ToTo279/BETH/Modelle/Gehaeuese/Stuetze3D.stl

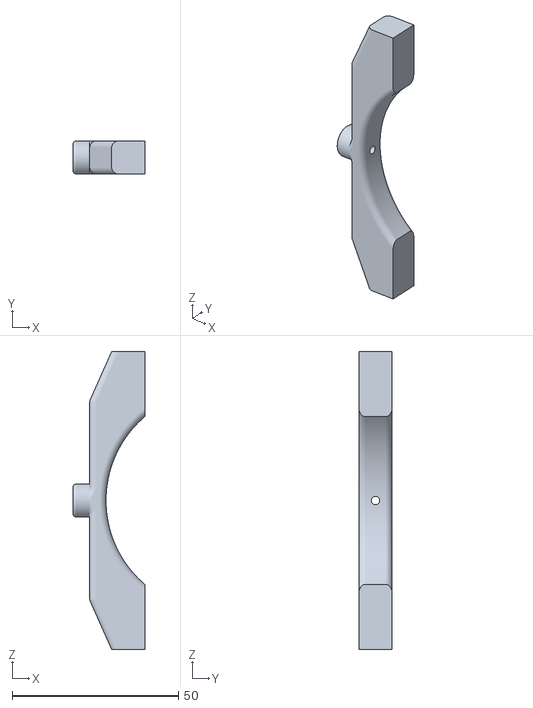
[picture p2: CAD file, 2024-02-24]
Modelle/Gehaeuese/Stuetze3D.stl
21.6 x 10.0 x 89.6
