ToTo279/BETH/Modelle/Gehaeuese/LED3D.stl

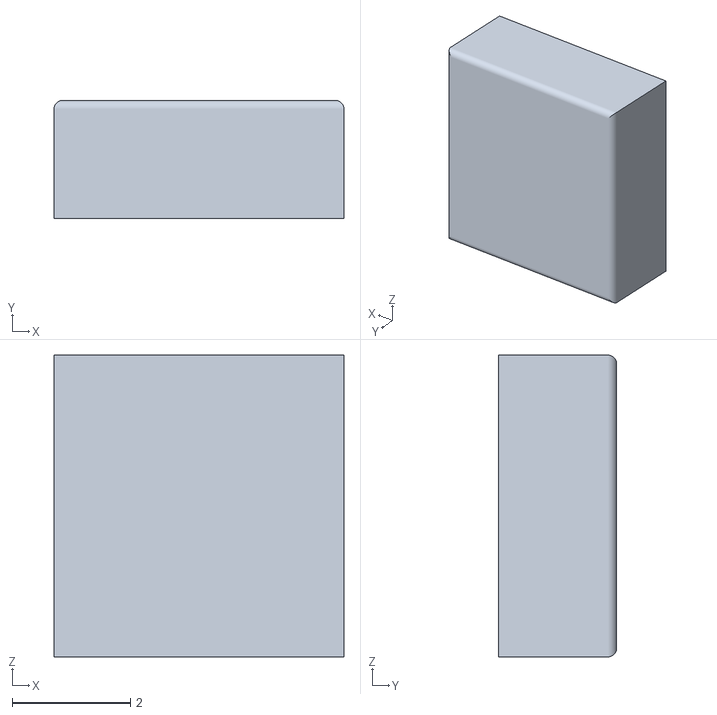
[picture p3: CAD file, 2024-02-24]
Modelle/Gehaeuese/LED3D.stl
4.90 x 2.00 x 5.10
