ToTo279/BETH/(list of files, cad)

Other CAD files:
Modelle/Gehaeuese/LED.ipt
Modelle/Gehaeuese/Oberteil.ipt
Modelle/Gehaeuese/Stuetze.ipt
Modelle/Gehaeuese/Unterteil.ipt
Modelle/MainPCB.ipt
