ToTo279/BETH/Installationsanleitung.md

# Installationsanleitung

## Plattform IO installieren
1. Installiere [Platform IO](https://platformio.org/) auf deinem Entwicklungssystem.

## Raspberry Pi konfigurieren
1. Kopiere den Ordner `Code/raspberryPi` in das Verzeichnis deines Raspberry Pi.
2. Öffne den Ordner `Code/BETH` und verwende PlatformIO, um den Code hochzuladen.

## Raspberry Pi Konfigurationen:
- Starte einen Hotspot mit dem Namen "basepi" und dem Passwort "rasbase331".
