ToTo279/BETH/Modelle/LEDPlatine/LeiterplatteLED.brd

## EAGLE design Modelle/LEDPlatine/LeiterplatteLED.brd (2024-02-24)

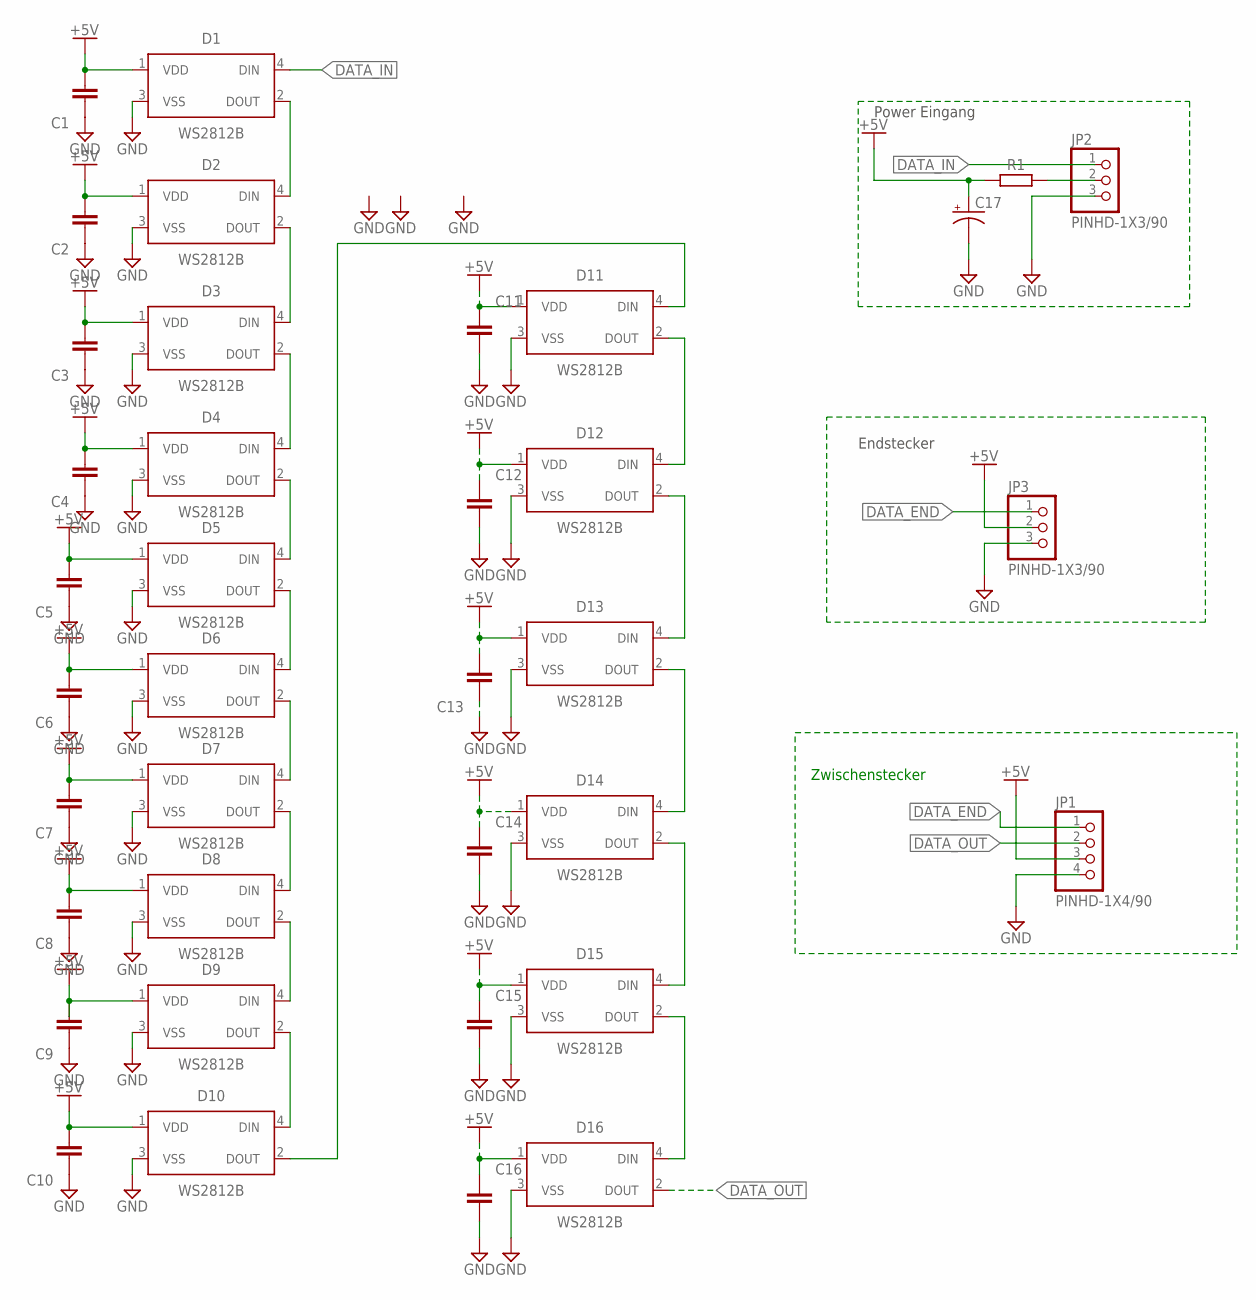
[picture p4: schematic StromlaufplanLED.sch]

Parts:
C1, C2, C3, C4, C5, C6, C7, C8, C9, C10, C11, C12, C13, C14, C15, C16: C_CHIP-1206(3216-METRIC); CAPC3216X135
C17: C-POL-US_TANTALUM-1206(3216-METRIC); CAPMP3216X180N
D1, D2, D3, D4, D5, D6, D7, D8, D9, D10, D11, D12, D13, D14, D15, D16: WS2812B
JP1: PINHD-1X4/90; 1X04/90
JP2, JP3: PINHD-1X3/90; 1X03/90
R1: R_CHIP-1206(3216-METRIC); RESC3216X70

Connections:
+5V: C1.2, C2.2, C3.2, C4.2, C5.2, C6.2, C7.2, C8.2, C9.2, C10.2, C11.1, C12.1, C13.2, C14.1, C15.1, C16.1, C17.1 (+), D1.1 (VDD), D2.1 (VDD), D3.1 (VDD), D4.1 (VDD), D5.1 (VDD), D6.1 (VDD), D7.1 (VDD), D8.1 (VDD), D9.1 (VDD), D10.1 (VDD), D11.1 (VDD), D12.1 (VDD), D13.1 (VDD), D14.1 (VDD), D15.1 (VDD), D16.1 (VDD), JP1.3, JP3.2, R1.1
DATA_END: JP1.1, JP3.1
DATA_IN: D1.4 (DIN), JP2.1
DATA_OUT: D16.2 (DOUT), JP1.2
GND: C1.1, C2.1, C3.1, C4.1, C5.1, C6.1, C7.1, C8.1, C9.1, C10.1, C11.2, C12.2, C13.1, C14.2, C15.2, C16.2, C17.2 (-), D1.3 (VSS), D2.3 (VSS), D3.3 (VSS), D4.3 (VSS), D5.3 (VSS), D6.3 (VSS), D7.3 (VSS), D8.3 (VSS), D9.3 (VSS), D10.3 (VSS), D11.3 (VSS), D12.3 (VSS), D13.3 (VSS), D14.3 (VSS), D15.3 (VSS), D16.3 (VSS), JP1.4, JP2.3, JP3.3
unnamed: D14.2 (DOUT), D15.4 (DIN)
unnamed: D15.2 (DOUT), D16.4 (DIN)
unnamed: JP2.2, R1.2
unnamed: D2.2 (DOUT), D3.4 (DIN)
unnamed: D3.2 (DOUT), D4.4 (DIN)
unnamed: D4.2 (DOUT), D5.4 (DIN)
unnamed: D5.2 (DOUT), D6.4 (DIN)
unnamed: D6.2 (DOUT), D7.4 (DIN)
unnamed: D7.2 (DOUT), D8.4 (DIN)
unnamed: D8.2 (DOUT), D9.4 (DIN)
unnamed: D9.2 (DOUT), D10.4 (DIN)
unnamed: D10.2 (DOUT), D11.4 (DIN)
unnamed: D11.2 (DOUT), D12.4 (DIN)
unnamed: D12.2 (DOUT), D13.4 (DIN)
unnamed: D13.2 (DOUT), D14.4 (DIN)
unnamed: D1.2 (DOUT), D2.4 (DIN)

Notes on the sheet:
Power Eingang
Zwischenstecker
Endstecker

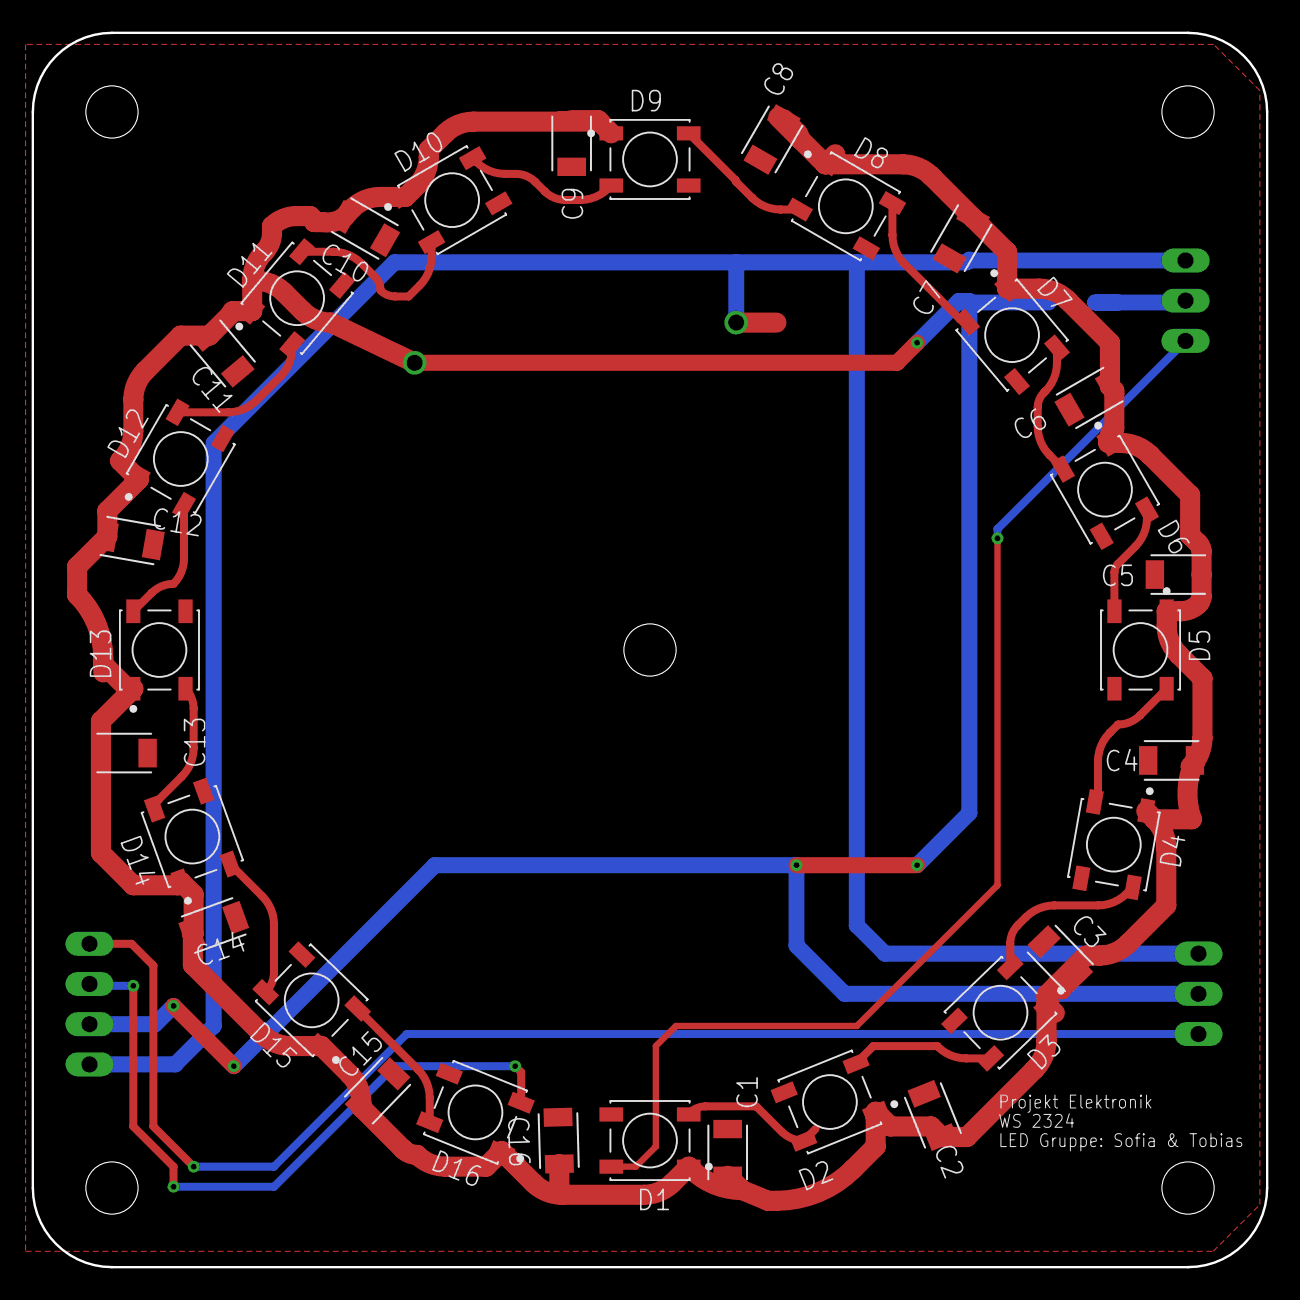
[picture p5: board LeiterplatteLED.brd from above]

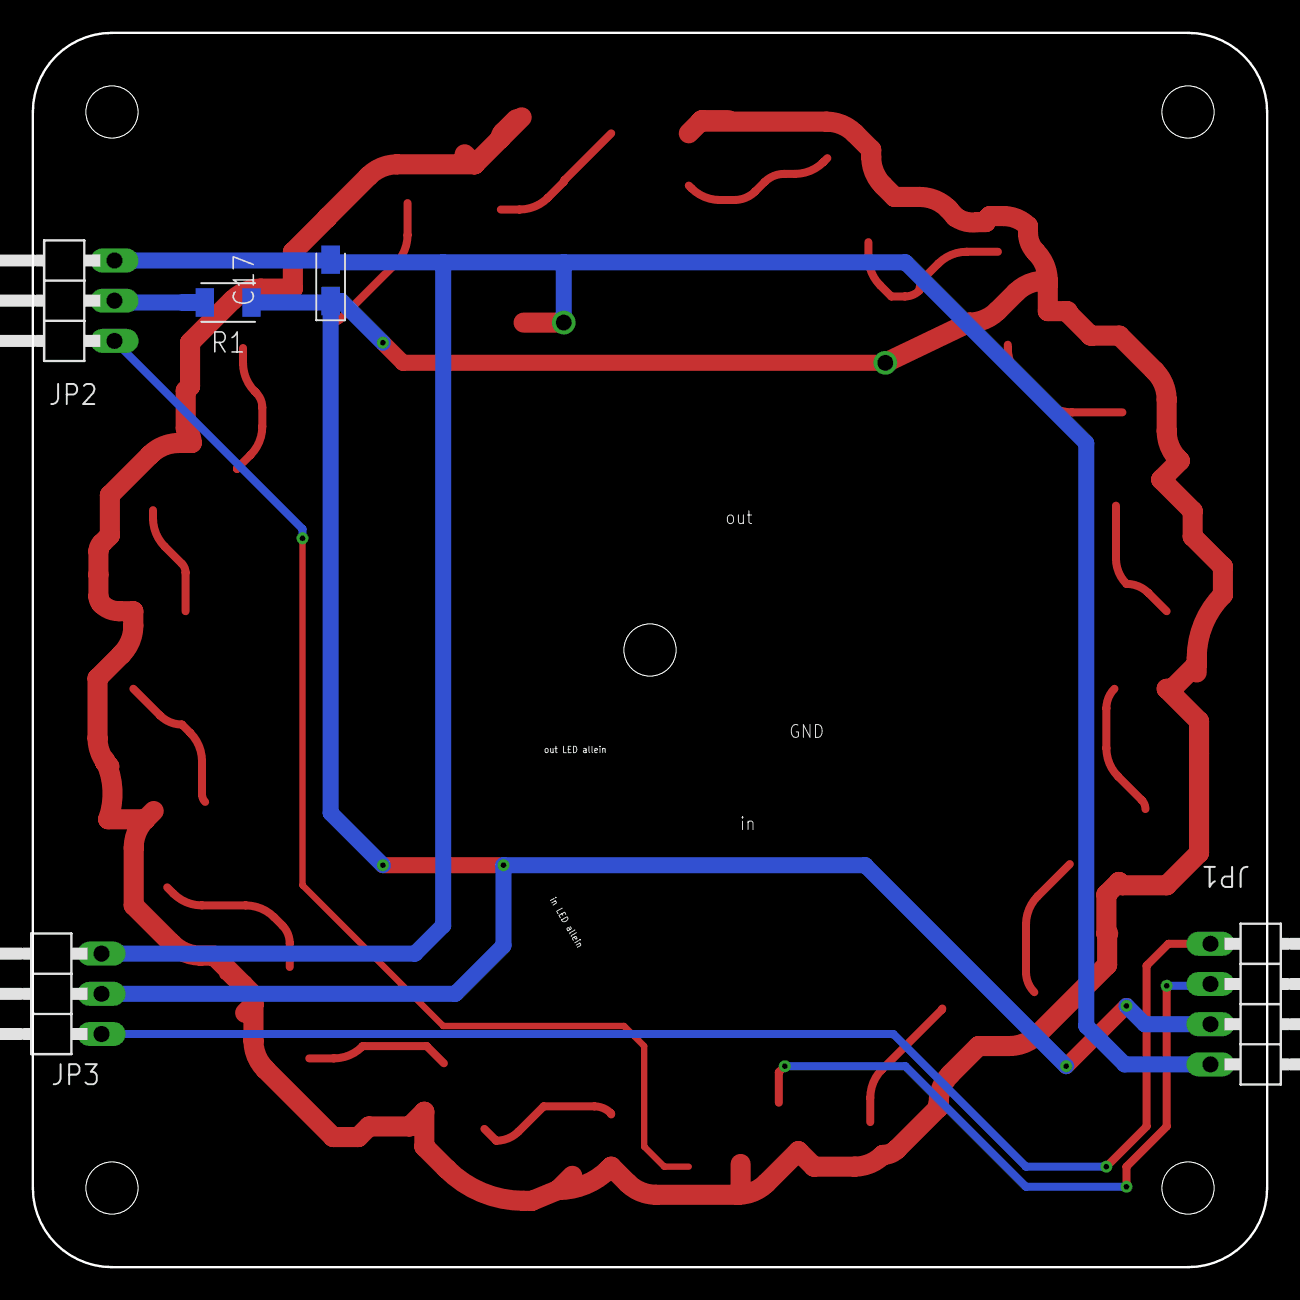
[picture p6: board LeiterplatteLED.brd from below]

Board: 2 copper layers, 78.0 x 78.0 mm, 37 parts (5 on the bottom side), 21 nets.
