ToTo279/BETH/Modelle/EnergieversorgungsPlatine/LeiterplatteEnergieversorgung.brd

## EAGLE design Modelle/EnergieversorgungsPlatine/LeiterplatteEnergieversorgung.brd (2024-02-24)

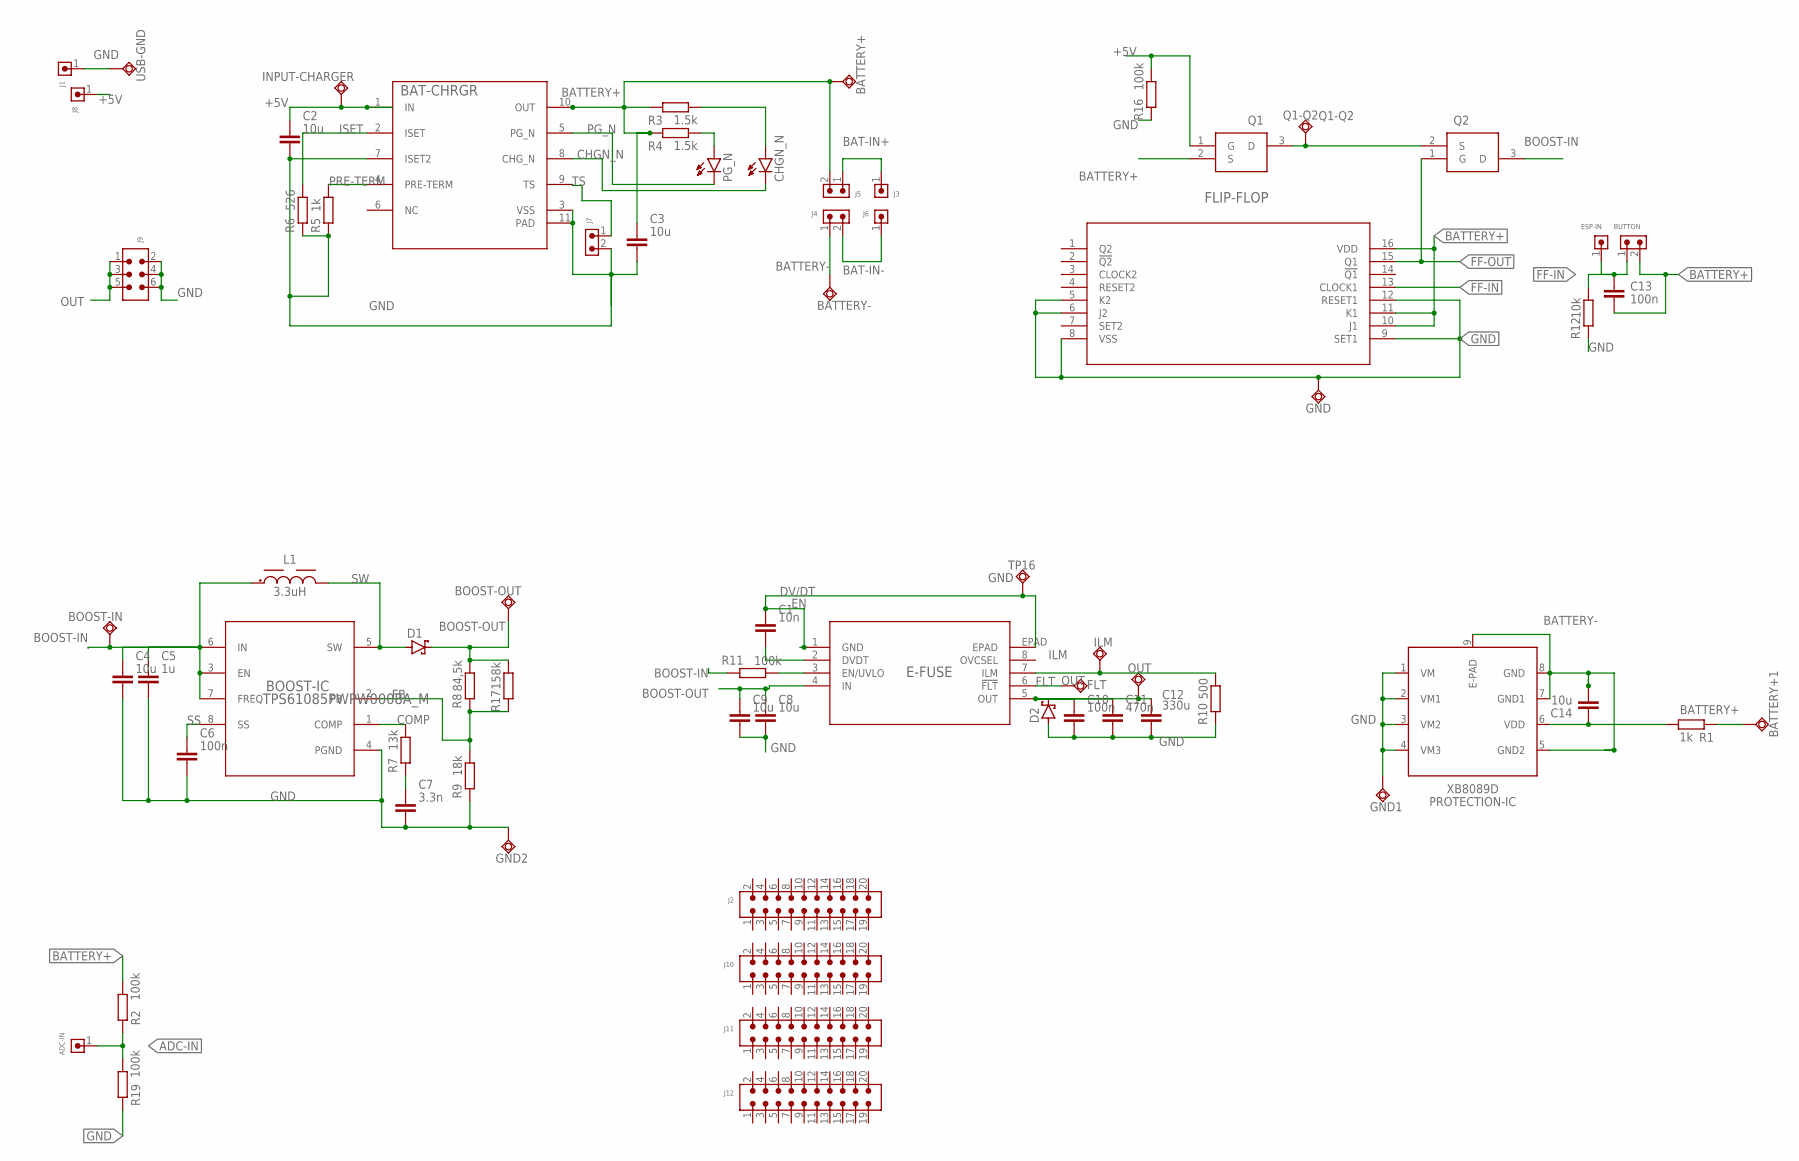
[picture p7: schematic StromlaufplanEnergieversorgung.sch]

Parts:
ADC-IN: 6130XX11121_61300111121; 61300111121
BAT-CHRGR: BQ24092DGQRDGQ0010D_NV_L; DGQ0010D_NV_L
BATTERY+, BATTERY+1: TPSQPAD1-13; P1-13
BATTERY-: TPSQPAD1-13; P1-13
BOOST-IC: TPS61085PWPW0008A_M; PW0008A_M
BOOST-IN: TPSQPAD1-13; P1-13
BOOST-OUT: TPSQPAD1-13; P1-13
BUTTON: 6130XX11121_61300211121; 61300211121
C1: 10n; CAPC3216X135
C2, C3, C4, C8, C9, C14: 10u; CAPC3216X135
C5: 1u; CAPC3216X135
C6, C10, C13: 100n; CAPC3216X135
C7: 3.3n; CAPC3216X135
C11: 470n; CAPC3216X135
C12: 330u; CAPRD550W60D1025H1250B
CHGN_N: LEDCHIPLED_1206; CHIPLED_1206
D1, D2: SCHOTTKY-DIODESMD; SMB
E-FUSE: TPS259620DDARSOIC_20DDAR_TEX-M; SOIC_20DDAR_TEX-M
ESP-IN: 6130XX11121_61300111121; 61300111121
FLIP-FLOP: CD4027BNSRNS16; NS16
FLT: TPSQPAD1-13; P1-13
GND, GND1, GND2: TPSQPAD1-13; P1-13
ILM: TPSQPAD1-13; P1-13
INPUT-CHARGER: TPSQPAD1-13; P1-13
J1, J3, J6, J8: 6130XX11121_61300111121; 61300111121
J2, J10, J11, J12: 6130XX21121_61302021121; 61302021121
J4, J5, J7: 6130XX11121_61300211121; 61300211121
J9: 6130XX21121_61300621121; 61300621121
L1: 3.3uH; WE-PD_7345
OUT: TPSQPAD1-13; P1-13
PG_N: LEDCHIPLED_1206; CHIPLED_1206
PROTECTION-IC: XB8089D
Q1, Q2: DMP3098L-7; SOT96P240X110-3N
Q1-Q2: TPSQPAD1-13; P1-13
R1, R5: 1k; RESC3216X70
R2, R11, R16, R19: 100k; RESC3216X70
R3, R4: 1.5k; RESC3216X70
R6: 526; RESC3216X70
R7: 13k; RESC3216X70
R8: 84,5k; RESC3216X70
R9: 18k; RESC3216X70
R10: 500; RESC3216X70
R12: 10k; RESC3216X70
R17: 158k; RESC3216X70
TP16: TPSQPAD1-13; P1-13
USB-GND: TPSQPAD1-13; P1-13

Connections:
+5V: BAT-CHRGR.1 (IN), C2.1, INPUT-CHARGER.TP, J8.1, Q1.1 (G), R16.2
ADC-IN: ADC-IN.1, R2.2, R19.1
BAT-IN+: J3.1, J5.1
BAT-IN-: J4.2, J6.1
BATTERY+: BAT-CHRGR.10 (OUT), BATTERY+.TP, BATTERY+1.TP, BUTTON.2, C3.1, C13.2, FLIP-FLOP.10 (J1), FLIP-FLOP.11 (K1), FLIP-FLOP.16 (VDD), J5.2, Q1.2 (S), R1.1, R2.1, R3.2, R4.2
BATTERY-: BATTERY-.TP, C14.2, J4.1, PROTECTION-IC.5 (GND2), PROTECTION-IC.7 (GND1), PROTECTION-IC.8 (GND), PROTECTION-IC.9 (E-PAD)
BOOST-IN: BOOST-IC.3 (EN), BOOST-IC.6 (IN), BOOST-IC.7 (FREQ), BOOST-IN.TP, C4.1, C5.1, L1.1, Q2.3 (D), R11.1
BOOST-OUT: BOOST-OUT.TP, C8.1, C9.1, D1.C, E-FUSE.4 (IN), R8.2, R17.2
CHGN_N: BAT-CHRGR.8 (CHG_N), CHGN_N.C
COMP: BOOST-IC.1 (COMP), R7.2
DV/DT: C1.2, E-FUSE.2 (DVDT)
EN: E-FUSE.3 (EN/UVLO), R11.2
FB: BOOST-IC.2 (FB), R8.1, R9.2, R17.1
FF-IN: BUTTON.1, C13.1, ESP-IN.1, FLIP-FLOP.13 (CLOCK1), R12.2
FF-OUT: FLIP-FLOP.15 (Q1), Q2.1 (G)
FLT: E-FUSE.6 (!FLT), FLT.TP
GND: BAT-CHRGR.3 (VSS), BAT-CHRGR.7 (ISET2), BAT-CHRGR.11 (PAD), BOOST-IC.4 (PGND), C1.1, C2.2, C3.2, C4.2, C5.2, C6.2, C7.2, C8.2, C9.2, C10.2, C11.2, C12.2, D2.A, E-FUSE.1 (GND), E-FUSE.EPAD, FLIP-FLOP.5 (K2), FLIP-FLOP.6 (J2), FLIP-FLOP.8 (VSS), FLIP-FLOP.9 (SET1), FLIP-FLOP.12 (RESET1), GND.TP, GND1.TP, GND2.TP, J1.1, J7.2, J9.2, J9.4, J9.6, PROTECTION-IC.1 (VM), PROTECTION-IC.2 (VM1), PROTECTION-IC.3 (VM2), PROTECTION-IC.4 (VM3), R5.1, R6.1, R9.1, R10.1, R12.1, R16.1, R19.2, TP16.TP, USB-GND.TP
ILM: E-FUSE.7 (ILM), ILM.TP, R10.2
ISET: BAT-CHRGR.2 (ISET), R6.2
unnamed: C14.1, PROTECTION-IC.6 (VDD), R1.2
unnamed: CHGN_N.A, R3.1
unnamed: PG_N.A, R4.1
unnamed: C7.1, R7.1
OUT: C10.1, C11.1, C12.1, D2.C, E-FUSE.5 (OUT), J9.1, J9.3, J9.5, OUT.TP
PG_N: BAT-CHRGR.5 (PG_N), PG_N.C
PRE-TERM: BAT-CHRGR.4 (PRE-TERM), R5.2
Q1-Q2: Q1.3 (D), Q1-Q2.TP, Q2.2 (S)
SS: BOOST-IC.8 (SS), C6.1
SW: BOOST-IC.5 (SW), D1.A, L1.2
TS: BAT-CHRGR.9 (TS), J7.1

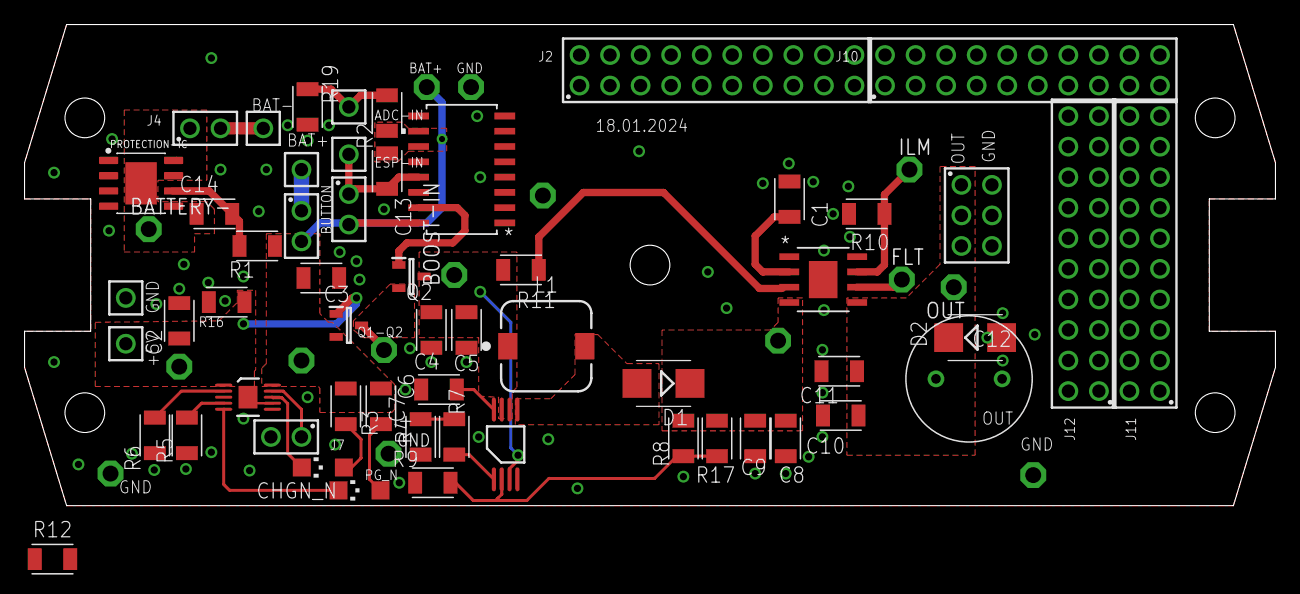
[picture p8: board LeiterplatteEnergieversorgung.brd from above]

Board: 2 copper layers, 104.0 x 40.0 mm, 71 parts (0 on the bottom side), 30 nets.
