ToTo279/BETH/Modelle/AudioPlatine/LeiterplatteAudio.brd

## EAGLE design Modelle/AudioPlatine/LeiterplatteAudio.brd (2024-02-24)

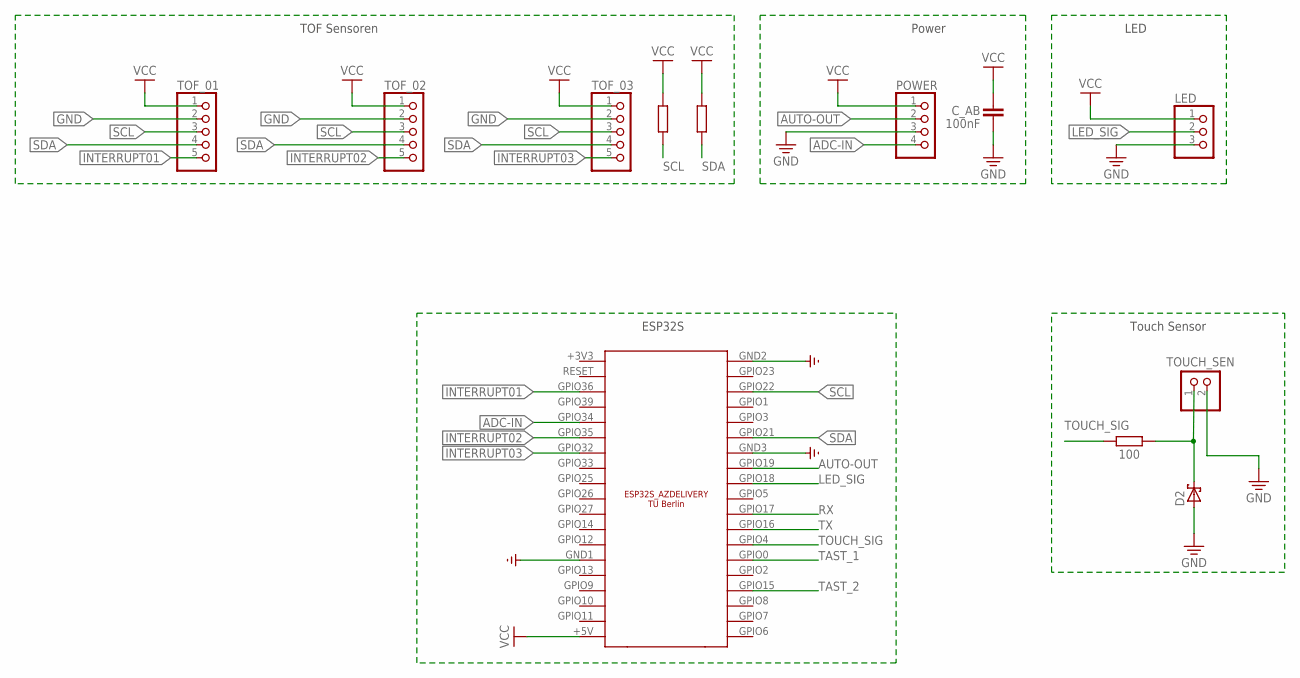
[picture p9: schematic StromlaufplanAudio.sch, sheet 1, ESP32]

Parts:
C_AB: 100nF; C1206K
D2: 1PS79SB30; SOD523
LED: PINHD-1X3/90; 1X03/90
POWER: PINHD-1X4/90; 1X04/90
R_FIL_6, R_FIL_7: 100; R1206
R_TOUCH: 100; R1206
TOF_01, TOF_02, TOF_03: PINHD-1X5/90; 1X05/90
TOUCH_SEN: PINHD-1X2/90; 1X02/90
U$1: ESP32S_AZDELIVERY

Connections:
ADC-IN: POWER.4, U$1.GPIO34
AUTO-OUT: POWER.2, U$1.GPIO19
GND: C_AB.1, D2.2 (A), LED.3, POWER.3, TOF_01.2, TOF_02.2, TOF_03.2, TOUCH_SEN.2, U$1.GND1, U$1.GND2, U$1.GND3; also elsewhere on the board
INTERRUPT01: TOF_01.5, U$1.GPIO36
INTERRUPT02: TOF_02.5, U$1.GPIO35
INTERRUPT03: TOF_03.5, U$1.GPIO32
LED_SIG: LED.2, U$1.GPIO18
unnamed: D2.1 (K), R_TOUCH.1, TOUCH_SEN.1
RX: U$1.GPIO17; also elsewhere on the board
SCL: R_FIL_6.2, TOF_01.3, TOF_02.3, TOF_03.3, U$1.GPIO22
SDA: R_FIL_7.2, TOF_01.4, TOF_02.4, TOF_03.4, U$1.GPIO21
TAST_1: U$1.GPIO0; also elsewhere on the board
TAST_2: U$1.GPIO15; also elsewhere on the board
TOUCH_SIG: R_TOUCH.2, U$1.GPIO4
TX: U$1.GPIO16; also elsewhere on the board
VCC: C_AB.2, LED.1, POWER.1, R_FIL_6.1, R_FIL_7.1, TOF_01.1, TOF_02.1, TOF_03.1, U$1.+5V; also elsewhere on the board

Notes on the sheet:
TOF Sensoren
Power
LED
Touch Sensor
ESP32S

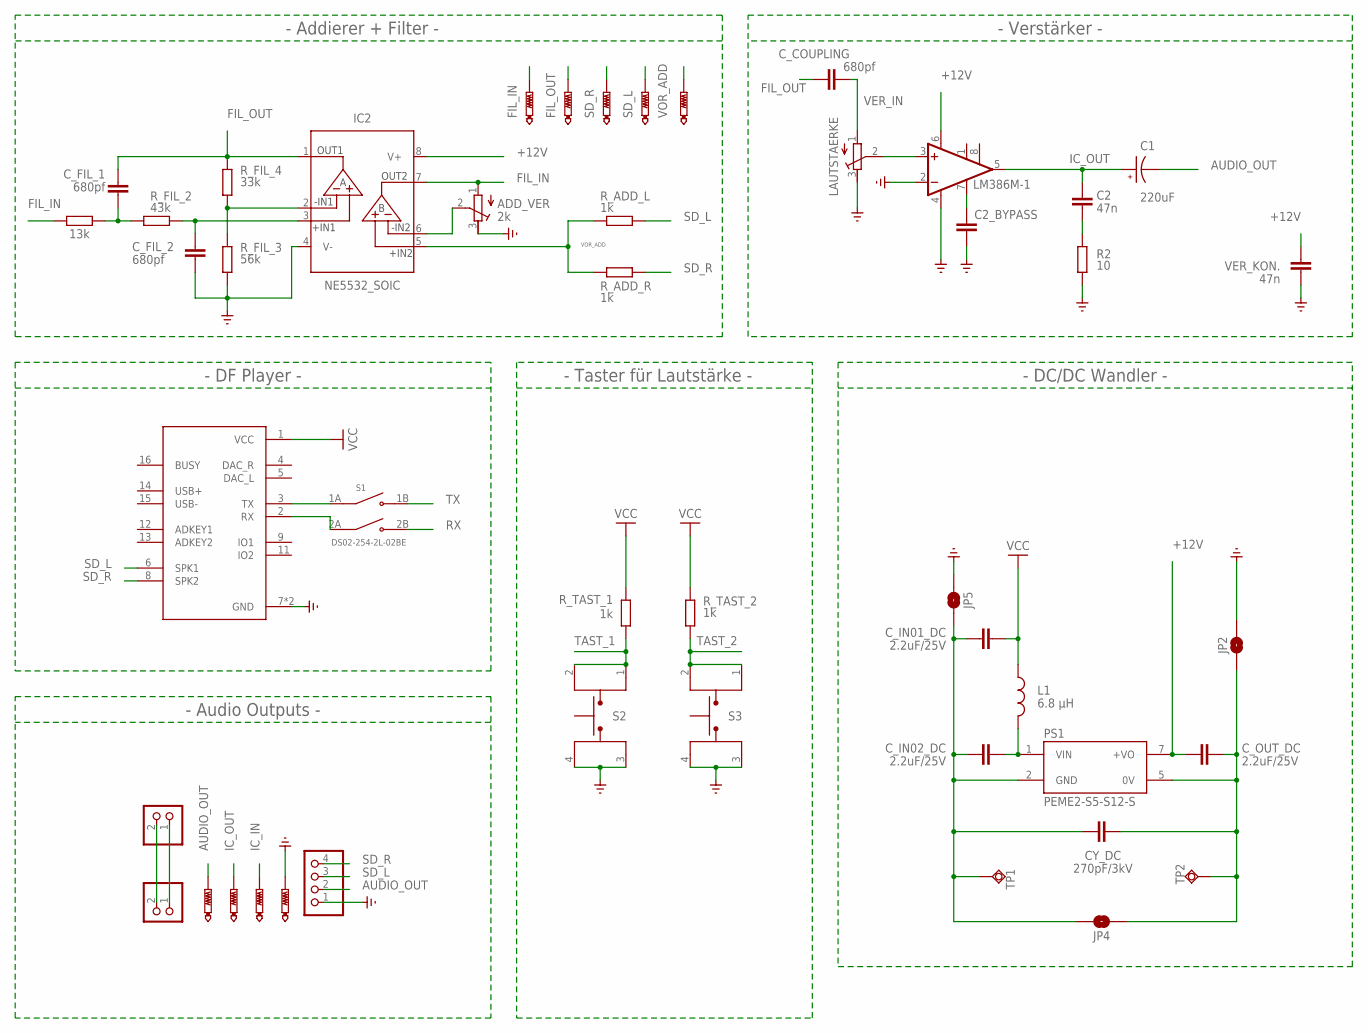
[picture p10: schematic StromlaufplanAudio.sch, sheet 2, Audio Gruppe]

Parts:
ADD_OUT->FIL_IN: PTR1TP10R; TP10R
ADD_VER: 2k; RTRIM4G/J
AUDIO_OUT1: PTR1TP10R; TP10R
C1: 220uF; CAP_EEEFTE221XAP
C2: 47n; C1206K
C2_BYPASS: C-EUC1206K; C1206K
CY_DC: 270pF/3kV; C1206K
C_COUPLING: 680pf; C1206K
C_FIL_1, C_FIL_2: 680pf; C1206K
C_IN01_DC, C_IN02_DC: 2.2uF/25V; C1206K
C_OUT_DC: 2.2uF/25V; C1206K
FIL_OUT->AUDIO_IN: PTR1TP10R; TP10R
GND: PTR1TP10R; TP10R
IC1: LM386M-1; SO08
IC2: NE5532_SOIC; SOIC127P600X175-8N
IC_IN: PTR1TP10R; TP10R
IC_OUT: PTR1TP10R; TP10R
JP1, JP6: PINHD-1X2; 1X02
JP2, JP4, JP5: JUMPER-SMT_2_NO_SILK; SMT-JUMPER_2_NO_SILK
JP3: PINHD-1X4; 1X04
L1: 6.8 μH; INDC3216X190
LAUTSTAERKE: R-TRIMM4G/J; RTRIM4G/J
PS1: PEME2-S5-S12-S; CONV_PEME2-S5-S12-S
R2: 10; R1206
R_ADD_L: 1k; R1206
R_ADD_R: 1k; R1206
R_FIL_1: 13k; R1206
R_FIL_2: 43k; R1206
R_FIL_3: 56k; R1206
R_FIL_4: 33k; R1206
R_TAST_1, R_TAST_2: 1k; R1206
S1: DS02-254-2L-02BE; SW_DS02-254-2L-02BE
S2, S3: TL3305AF160QG; SW_TL3305AF160QG
SD_L: PTR1TP10R; TP10R
SD_R: PTR1TP10R; TP10R
TP1, TP2: TPSQPAD1-20Y; P1-20Y
U1: DFR0299; MODULE_DFR0299
VER_KON.: 47n; C1206K
VOR_ADD: PTR1TP10R; TP10R

Connections:
+12V: C_OUT_DC.1, IC1.6 (VS), IC2.8 (V+), PS1.7 (+VO), VER_KON..2
AUDIO_OUT: AUDIO_OUT1.TP, C1.2, JP3.2
FIL_IN: ADD_OUT->FIL_IN.TP, ADD_VER.1 (A), IC2.7 (OUT2), R_FIL_1.2
FIL_OUT: C_COUPLING.2, C_FIL_1.2, FIL_OUT->AUDIO_IN.TP, IC2.1 (OUT1), R_FIL_4.2
GND: ADD_VER.3 (E), C2_BYPASS.1, C_FIL_2.1, GND.TP, IC1.2 (-IN), IC1.4 (GND), IC2.4 (V-), JP2.2, JP3.1, JP5.1, LAUTSTAERKE.3 (E), R2.1, R_FIL_3.1, S2.3, S2.4, S3.3, S3.4, U1.7 (GND), U1.10 (GND), VER_KON..1; also elsewhere on the board
IC_IN: IC1.3 (+IN), IC_IN.TP, LAUTSTAERKE.2 (S)
IC_OUT: C1.1, C2.2, IC1.5 (OUT), IC_OUT.TP
unnamed: IC2.2 (-IN1), R_FIL_3.2, R_FIL_4.1
unnamed: C2_BYPASS.2, IC1.7 (BYPASS)
unnamed: C2.1, R2.2
unnamed: C_FIL_1.1, R_FIL_1.1, R_FIL_2.2
unnamed: C_FIL_2.2, IC2.3 (+IN1), R_FIL_2.1
unnamed: S1.1A (COM1), U1.3 (TX)
unnamed: S1.2A (COM2), U1.2 (RX)
unnamed: JP1.2, JP6.2
unnamed: JP1.1, JP6.1
unnamed: ADD_VER.2 (S), IC2.6 (-IN2)
unnamed: C_IN02_DC.2, L1.2, PS1.1 (VIN)
unnamed: CY_DC.2, C_OUT_DC.2, JP2.1, JP4.1, PS1.5 (0V), TP2.TP
unnamed: CY_DC.1, C_IN01_DC.1, C_IN02_DC.1, JP4.2, JP5.2, PS1.2 (GND), TP1.TP
RX: S1.2B (NO2); also elsewhere on the board
SD_L: JP3.3, R_ADD_L.1, SD_L.TP, U1.6 (SPK1)
SD_R: JP3.4, R_ADD_R.1, SD_R.TP, U1.8 (SPK2)
TAST_1: R_TAST_1.1, S2.1, S2.2; also elsewhere on the board
TAST_2: R_TAST_2.1, S3.1, S3.2; also elsewhere on the board
TX: S1.1B (NO1); also elsewhere on the board
VCC: C_IN01_DC.2, L1.1, R_TAST_1.2, R_TAST_2.2, U1.1 (VCC); also elsewhere on the board
VER_IN: C_COUPLING.1, LAUTSTAERKE.1 (A)
VOR_ADD: IC2.5 (+IN2), R_ADD_L.2, R_ADD_R.2, VOR_ADD.TP

Notes on the sheet:
- Audio Outputs -
- DF Player -
- Taster für Lautstärke -
- Verstärker -
- Addierer + Filter -
- DC/DC Wandler -

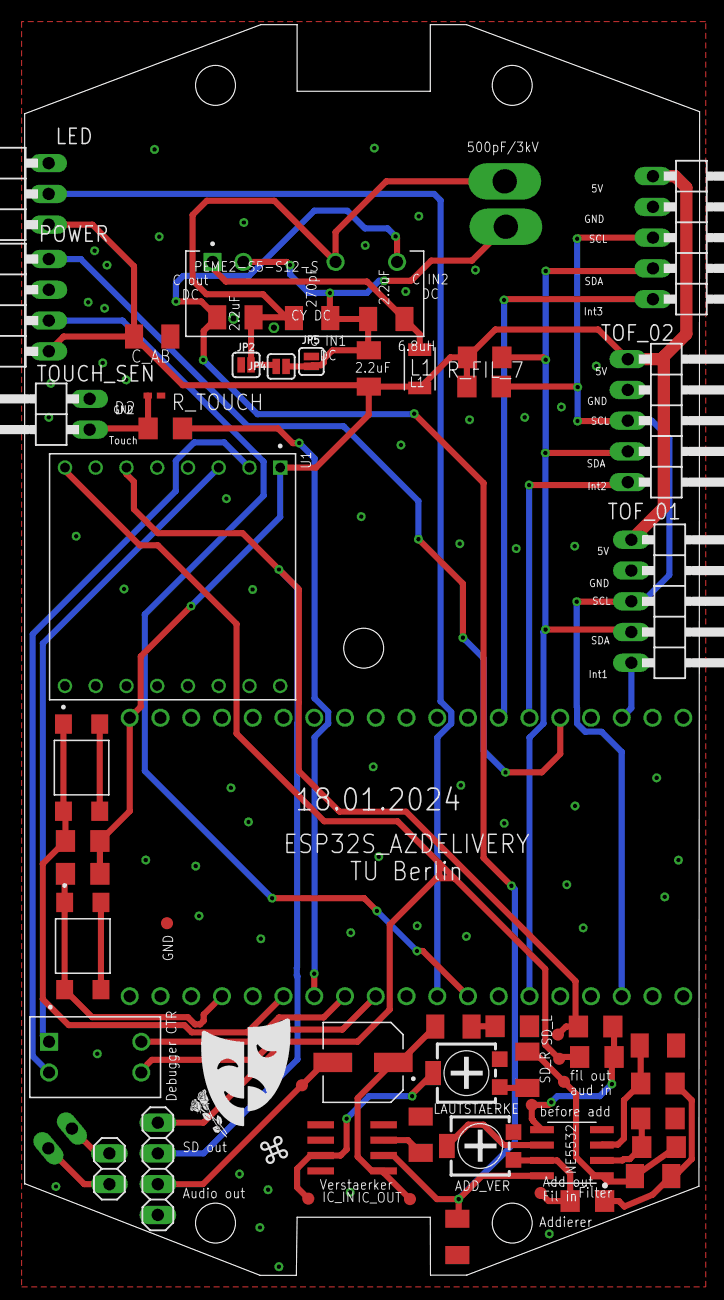
[picture p11: board LeiterplatteAudio.brd from above]

Board: 2 copper layers, 55.7 x 103.3 mm, 59 parts (1 on the bottom side), 39 nets.
