ToTo279/BETH/(commit log)

2024-02-24 led modell added
2024-02-24 modelle added
    [Audio.brd, Audio.sch, BatteryCharger.brd, BatteryCharger.sch, Leiterplatte_LED_Gruppe_fertig.brd, MainPCB.ipt, Stromlaufplan_LED_Gruppe_fertig.sch]
2024-02-24 gehäuse added
    [LED.ipt, LED3D.stl, Oberteil.ipt, Stuetze.ipt, Stuetze3D.stl, Unterteil.ipt]
