ToTo279/BETH/(notices)

Notices in the files:
parts and their libraries:
SparkFun-Jumpers: Licensing: Creative Commons ShareAlike 4.0 International - https://creativecommons.org/licenses/by-sa/4.0
BQ24092DGQR: COPYRIGHT: Copyright (C) 2023 Ultra Librarian. All rights reserved.
61001021121_Eagle_WR-PHD_rev19a: Copyright: Würth Elektronik
